firodrigz/domotica-arduino/Conexiones y proy terminado/img5.jpeg

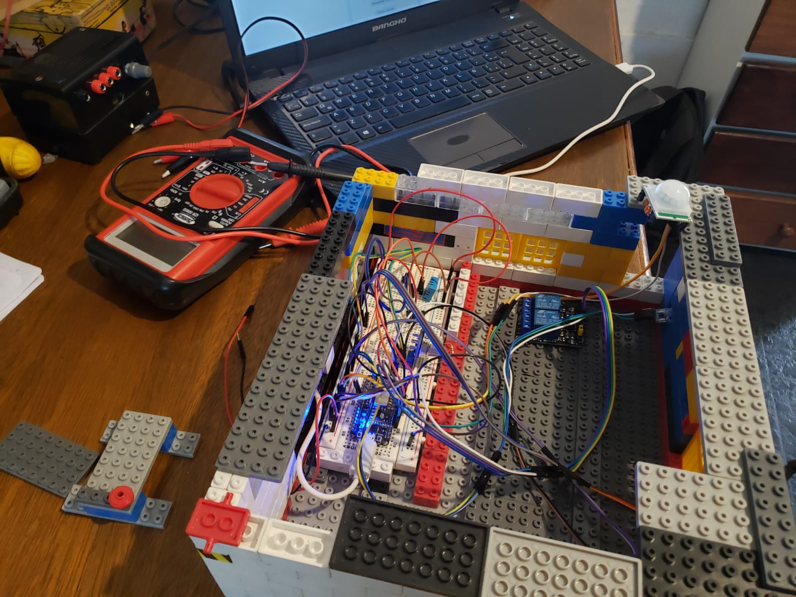
Conexiones y proy terminado/img5.jpeg
