firodrigz/domotica-arduino/Conexiones y proy terminado/img4.jpeg

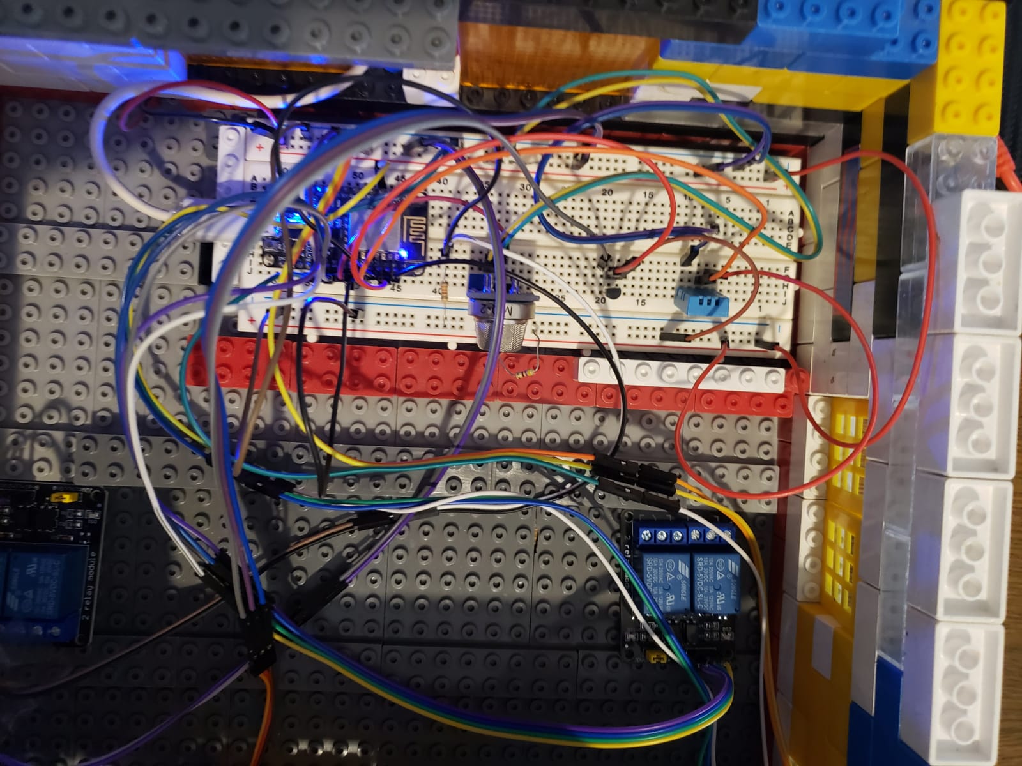
Conexiones y proy terminado/img4.jpeg
