firodrigz/domotica-arduino/Conexiones y proy terminado/conexiones.PNG

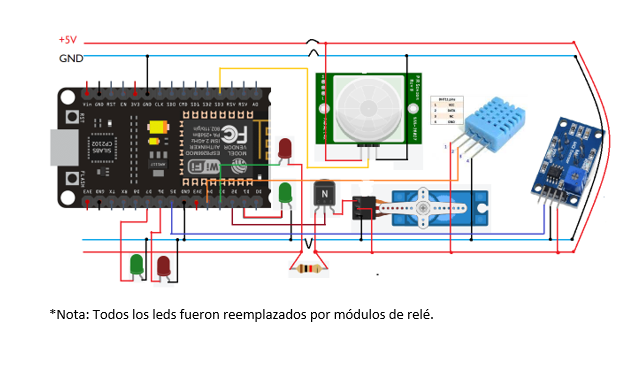
Conexiones y proy terminado/conexiones.PNG
