firodrigz/domotica-arduino/Conexiones y proy terminado/img1.jpeg

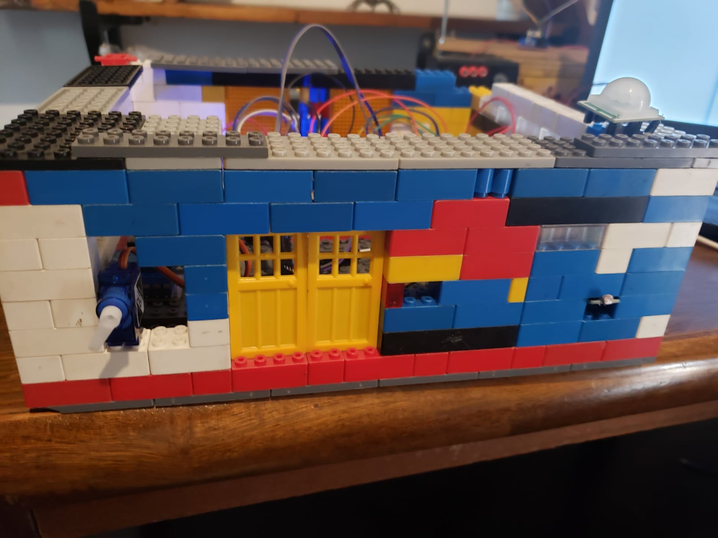
Conexiones y proy terminado/img1.jpeg
