firodrigz/domotica-arduino/Conexiones y proy terminado/img2.jpeg

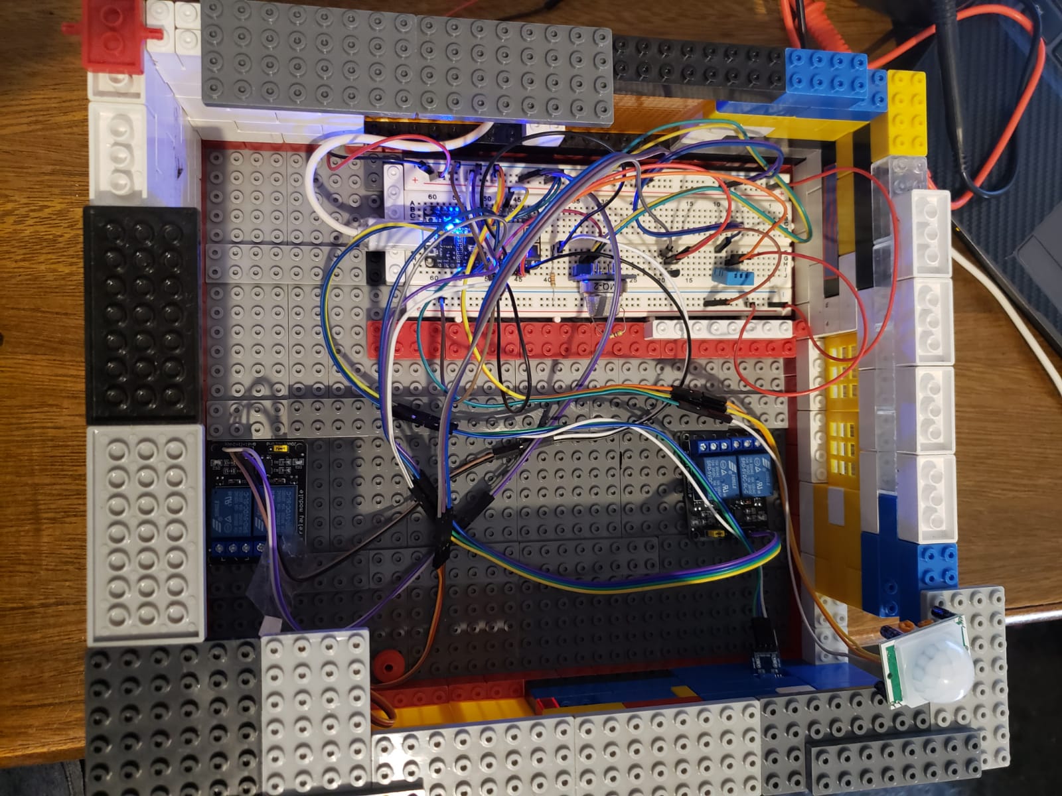
Conexiones y proy terminado/img2.jpeg
