firodrigz/domotica-arduino/Conexiones y proy terminado/img3.jpeg

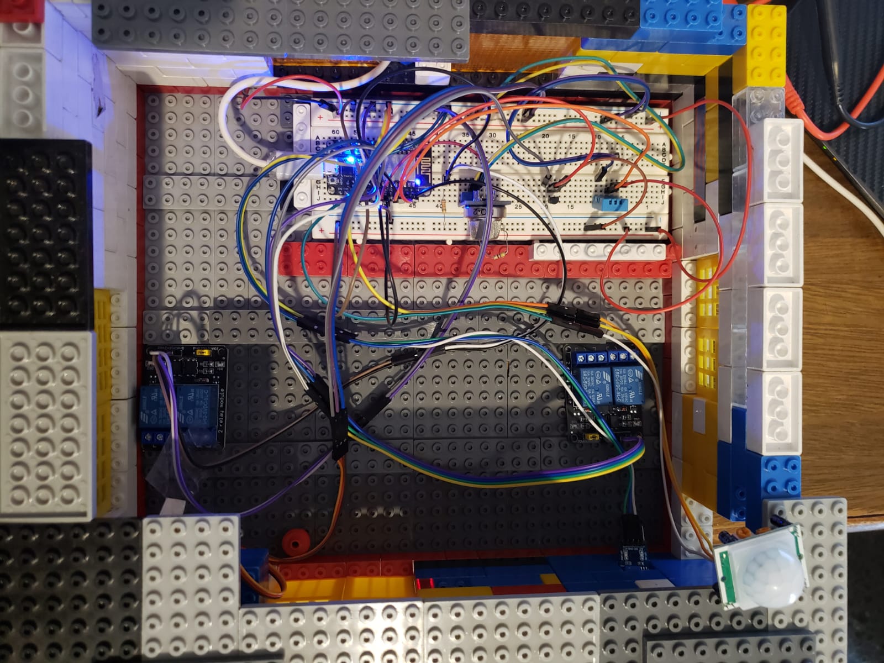
Conexiones y proy terminado/img3.jpeg
